shurcaz/Digital_Multimeter/README.md

# Digital_Multimeter
Digital Multimeter Project for the Design, Construction &amp; Test module at the University of York 2022
